cadenpage/rotom/legacy/pixi.md

[tasks]
ros2-build = "bash -lc 'cd /home/caden/Documents/rotom/src/ros2_ws; rm -rf build install log; source /opt/ros/humble/setup.bash; export COLCON_PYTHON_EXECUTABLE=/usr/bin/python3; colcon build --symlink-install --cmake-args -DPython3_EXECUTABLE=/usr/bin/python3; source install/setup.bash'"
ros2-control = "bash -lc 'export ROTOM_ROOT=/home/caden/Documents/rotom; export PYTHONPATH=/home/caden/Documents/rotom/src:/home/caden/Documents/rotom/.pixi/envs/default/lib/python3.10/site-packages:$PYTHONPATH; source /home/caden/Documents/rotom/src/ros2_ws/install/setup.bash; ros2 launch rotom_control rotom_control.launch.py'"
ros2-vision = "bash -lc 'export PIXI_LIB=/home/caden/Documents/rotom/.pixi/envs/default/lib; export PYTHONPATH=$PIXI_LIB/python3.10/site-packages:$PYTHONPATH; export LD_LIBRARY_PATH=$PIXI_LIB:$LD_LIBRARY_PATH; source /home/caden/Documents/rotom/src/ros2_ws/install/setup.bash; ros2 launch rotom_vision vision_pipeline.launch.py'"
ros2-vision-camera = "bash -lc 'export PIXI_LIB=/home/caden/Documents/rotom/.pixi/envs/default/lib; export PYTHONPATH=$PIXI_LIB/python3.10/site-packages:$PYTHONPATH; export LD_LIBRARY_PATH=$PIXI_LIB:$LD_LIBRARY_PATH; source /home/caden/Documents/rotom/src/ros2_ws/install/setup.bash; ros2 launch rotom_vision vision_pipeline.launch.py start_camera:=true'"
ros2-vision-servo = "bash -lc 'export ROTOM_ROOT=/home/caden/Documents/rotom; export PIXI_LIB=/home/caden/Documents/rotom/.pixi/envs/default/lib; export PYTHONPATH=/home/caden/Documents/rotom/src:$PIXI_LIB/python3.10/site-packages:$PYTHONPATH; export LD_LIBRARY_PATH=$PIXI_LIB:$LD_LIBRARY_PATH; source /home/caden/Documents/rotom/src/ros2_ws/install/setup.bash; ros2 launch rotom_vision vision_pipeline.launch.py start_camera:=true start_control:=true enable_servo:=true'"
ros2-marker-follow-dry = "bash -lc 'export ROTOM_ROOT=/home/caden/Documents/rotom; export PIXI_LIB=/home/caden/Documents/rotom/.pixi/envs/default/lib; export PYTHONPATH=/home/caden/Documents/rotom/src:$PIXI_LIB/python3.10/site-packages:$PYTHONPATH; export LD_LIBRARY_PATH=$PIXI_LIB:$LD_LIBRARY_PATH; source /home/caden/Documents/rotom/src/ros2_ws/install/setup.bash; ros2 launch rotom_vision marker_follow.launch.py'"
ros2-marker-follow-live = "bash -lc 'export ROTOM_ROOT=/home/caden/Documents/rotom; export PIXI_LIB=/home/caden/Documents/rotom/.pixi/envs/default/lib; export PYTHONPATH=/home/caden/Documents/rotom/src:$PIXI_LIB/python3.10/site-packages:$PYTHONPATH; export LD_LIBRARY_PATH=$PIXI_LIB:$LD_LIBRARY_PATH; source /home/caden/Documents/rotom/src/ros2_ws/install/setup.bash; ros2 launch rotom_vision marker_follow.launch.py enable_servo:=true'"
ros2-marker-follow-dry-rviz = "bash -lc 'export ROTOM_ROOT=/home/caden/Documents/rotom; export PIXI_LIB=/home/caden/Documents/rotom/.pixi/envs/default/lib; export PYTHONPATH=/home/caden/Documents/rotom/src:$PIXI_LIB/python3.10/site-packages:$PYTHONPATH; export LD_LIBRARY_PATH=$PIXI_LIB:$LD_LIBRARY_PATH; source /home/caden/Documents/rotom/src/ros2_ws/install/setup.bash; ros2 launch rotom_vision marker_follow.launch.py use_rviz:=true'"
ros2-marker-follow-live-rviz = "bash -lc 'export ROTOM_ROOT=/home/caden/Documents/rotom; export PIXI_LIB=/home/caden/Documents/rotom/.pixi/envs/default/lib; export PYTHONPATH=/home/caden/Documents/rotom/src:$PIXI_LIB/python3.10/site-packages:$PYTHONPATH; export LD_LIBRARY_PATH=$PIXI_LIB:$LD_LIBRARY_PATH; source /home/caden/Documents/rotom/src/ros2_ws/install/setup.bash; ros2 launch rotom_vision marker_follow.launch.py enable_servo:=true use_rviz:=true'"
ros2-marker-follow-moveit-dry = "bash -lc 'export ROTOM_ROOT=/home/caden/Documents/rotom; export PIXI_LIB=/home/caden/Documents/rotom/.pixi/envs/default/lib; export PYTHONPATH=/home/caden/Documents/rotom/src:$PIXI_LIB/python3.10/site-packages:$PYTHONPATH; export LD_LIBRARY_PATH=$PIXI_LIB:$LD_LIBRARY_PATH; source /home/caden/Documents/rotom/src/ros2_ws/install/setup.bash; ros2 launch rotom_moveit_config marker_follow_servo.launch.py'"
ros2-marker-follow-moveit-live = "bash -lc 'export ROTOM_ROOT=/home/caden/Documents/rotom; export PIXI_LIB=/home/caden/Documents/rotom/.pixi/envs/default/lib; export PYTHONPATH=/home/caden/Documents/rotom/src:$PIXI_LIB/python3.10/site-packages:$PYTHONPATH; export LD_LIBRARY_PATH=$PIXI_LIB:$LD_LIBRARY_PATH; source /home/caden/Documents/rotom/src/ros2_ws/install/setup.bash; ros2 launch rotom_moveit_config marker_follow_servo.launch.py enable_servo:=true'"
ros2-marker-follow-moveit-dry-rviz = "bash -lc 'export ROTOM_ROOT=/home/caden/Documents/rotom; export PIXI_LIB=/home/caden/Documents/rotom/.pixi/envs/default/lib; export PYTHONPATH=/home/caden/Documents/rotom/src:$PIXI_LIB/python3.10/site-packages:$PYTHONPATH; export LD_LIBRARY_PATH=$PIXI_LIB:$LD_LIBRARY_PATH; source /home/caden/Documents/rotom/src/ros2_ws/install/setup.bash; ros2 launch rotom_moveit_config marker_follow_servo.launch.py use_rviz:=true'"
ros2-marker-follow-moveit-live-rviz = "bash -lc 'export ROTOM_ROOT=/home/caden/Documents/rotom; export PIXI_LIB=/home/caden/Documents/rotom/.pixi/envs/default/lib; export PYTHONPATH=/home/caden/Documents/rotom/src:$PIXI_LIB/python3.10/site-packages:$PYTHONPATH; export LD_LIBRARY_PATH=$PIXI_LIB:$LD_LIBRARY_PATH; source /home/caden/Documents/rotom/src/ros2_ws/install/setup.bash; ros2 launch rotom_moveit_config marker_follow_servo.launch.py enable_servo:=true use_rviz:=true'"
ros2-drag-servo-dry = "bash -lc 'export ROTOM_ROOT=/home/caden/Documents/rotom; export PIXI_LIB=/home/caden/Documents/rotom/.pixi/envs/default/lib; export PYTHONPATH=/home/caden/Documents/rotom/src:$PIXI_LIB/python3.10/site-packages:$PYTHONPATH; export LD_LIBRARY_PATH=$PIXI_LIB:$LD_LIBRARY_PATH; source /home/caden/Documents/rotom/src/ros2_ws/install/setup.bash; ros2 launch rotom_vision drag_servo.launch.py'"
ros2-drag-servo-live = "bash -lc 'export ROTOM_ROOT=/home/caden/Documents/rotom; export PIXI_LIB=/home/caden/Documents/rotom/.pixi/envs/default/lib; export PYTHONPATH=/home/caden/Documents/rotom/src:$PIXI_LIB/python3.10/site-packages:$PYTHONPATH; export LD_LIBRARY_PATH=$PIXI_LIB:$LD_LIBRARY_PATH; source /home/caden/Documents/rotom/src/ros2_ws/install/setup.bash; ros2 launch rotom_vision drag_servo.launch.py enable_servo:=true'"
ros2-drag-servo-moveit-dry = "bash -lc 'export ROTOM_ROOT=/home/caden/Documents/rotom; export PIXI_LIB=/home/caden/Documents/rotom/.pixi/envs/default/lib; export PYTHONPATH=/home/caden/Documents/rotom/src:$PIXI_LIB/python3.10/site-packages:$PYTHONPATH; export LD_LIBRARY_PATH=$PIXI_LIB:$LD_LIBRARY_PATH; source /home/caden/Documents/rotom/src/ros2_ws/install/setup.bash; ros2 launch rotom_moveit_config drag_servo_moveit.launch.py'"
ros2-drag-servo-moveit-live = "bash -lc 'export ROTOM_ROOT=/home/caden/Documents/rotom; export PIXI_LIB=/home/caden/Documents/rotom/.pixi/envs/default/lib; export PYTHONPATH=/home/caden/Documents/rotom/src:$PIXI_LIB/python3.10/site-packages:$PYTHONPATH; export LD_LIBRARY_PATH=$PIXI_LIB:$LD_LIBRARY_PATH; source /home/caden/Documents/rotom/src/ros2_ws/install/setup.bash; ros2 launch rotom_moveit_config drag_servo_moveit.launch.py enable_servo:=true'"
calibrate-camera = "bash -lc 'export PIXI_LIB=/home/caden/Documents/rotom/.pixi/envs/default/lib; export PYTHONPATH=$PIXI_LIB/python3.10/site-packages:$PYTHONPATH; export LD_LIBRARY_PATH=$PIXI_LIB:$LD_LIBRARY_PATH; source /home/caden/Documents/rotom/src/ros2_ws/install/setup.bash; python /home/caden/Documents/rotom/src/examples/charuco_calibrate.py'"
charuco-camera = { cmd = "true", depends-on = ["ros2-vision-camera"] }
charuco-calibrate = { cmd = "true", depends-on = ["calibrate-camera"] }
move-group = "bash -lc 'source /home/caden/Documents/rotom/src/ros2_ws/install/setup.bash; ros2 launch rotom_moveit_config move_group.launch.py'"
moveit-rviz = "bash -lc 'source /home/caden/Documents/rotom/src/ros2_ws/install/setup.bash; ros2 launch rotom_moveit_config moveit_rviz.launch.py'"
moveit-demo-real = "bash -lc 'source /home/caden/Documents/rotom/src/ros2_ws/install/setup.bash; ros2 launch rotom_moveit_config demo.launch.py use_ros2_control:=false'"
calibration-gui = "bash -lc 'export PYTHONPATH=/home/caden/Documents/rotom/src:/home/caden/Documents/rotom/.pixi/envs/default/lib/python3.10/site-packages:$PYTHONPATH; python -m motors.calibration_gui'"
homing-offset = "bash -lc 'export PYTHONPATH=/home/caden/Documents/rotom/src:/home/caden/Documents/rotom/.pixi/envs/default/lib/python3.10/site-packages:$PYTHONPATH; python /home/caden/Documents/rotom/src/examples/homing_offset.py'"
home = "bash -lc 'export PYTHONPATH=/home/caden/Documents/rotom/src:/home/caden/Documents/rotom/.pixi/envs/default/lib/python3.10/site-packages:$PYTHONPATH; python /home/caden/Documents/rotom/src/examples/home.py'"
export-joint-limits = "bash -lc 'export PYTHONPATH=/home/caden/Documents/rotom/src:/home/caden/Documents/rotom/.pixi/envs/default/lib/python3.10/site-packages:$PYTHONPATH; python /home/caden/Documents/rotom/src/examples/export_joint_limits.py'"
