cadenpage/rotom/imgs/onshape.png

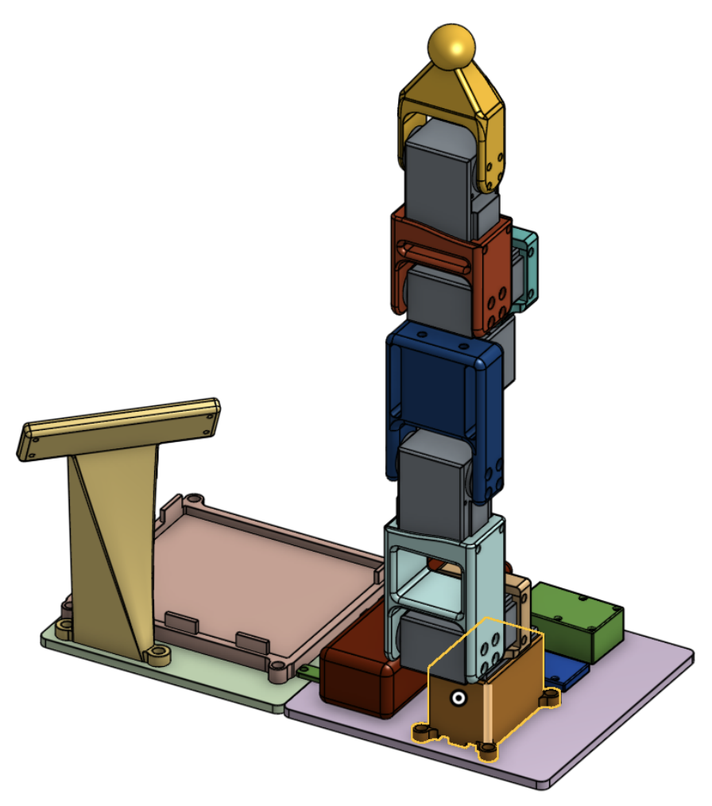
imgs/onshape.png
