cadenpage/rotom/src/ros2_ws/src/rotom_description/meshes/visual/link4.stl

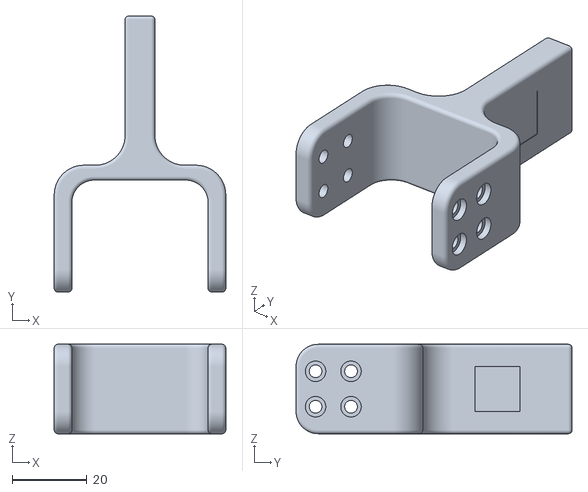
[picture p5: CAD file, 2026-03-18]
src/ros2_ws/src/rotom_description/meshes/visual/link4.stl
46.0 x 74.0 x 24.0
