cadenpage/rotom/src/ros2_ws/src/rotom_description/meshes/visual/ground.stl

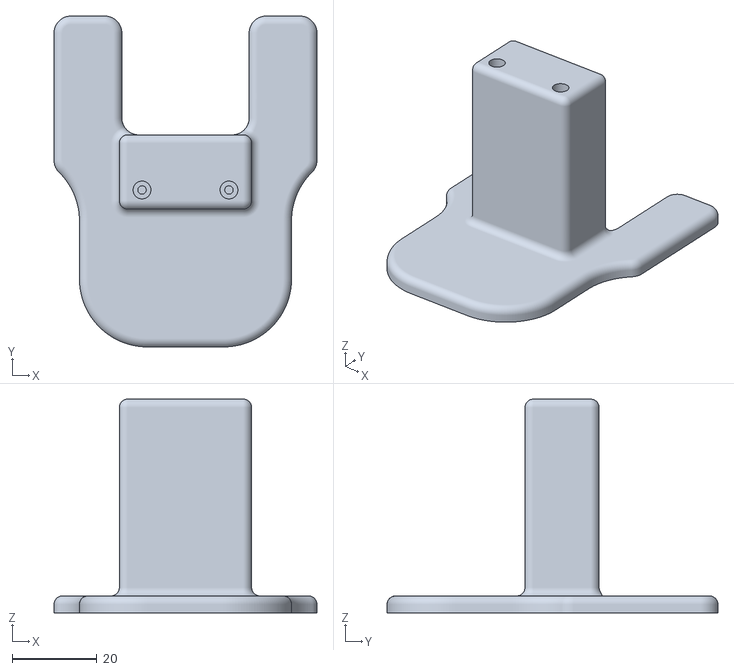
[picture p6: CAD file, 2026-03-17]
src/ros2_ws/src/rotom_description/meshes/visual/ground.stl
62.0 x 78.0 x 50.4
