cadenpage/rotom/src/ros2_ws/src/rotom_description/meshes/visual/flick2claw.stl

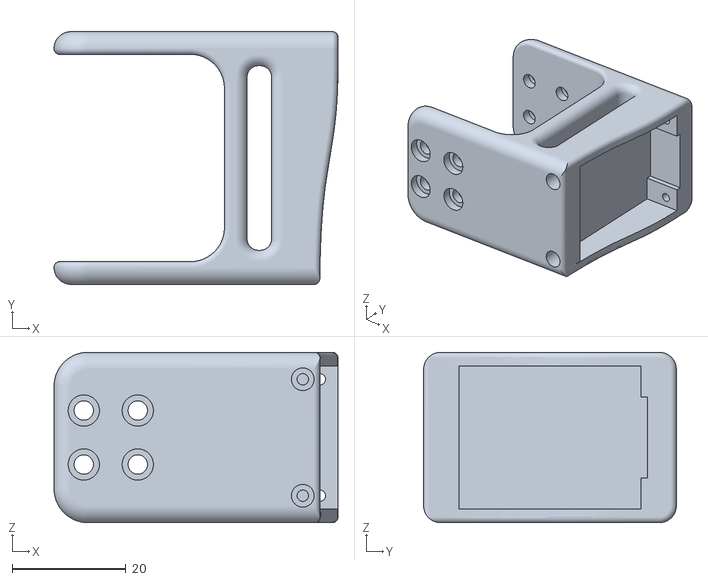
[picture p7: CAD file, 2026-01-10]
src/ros2_ws/src/rotom_description/meshes/visual/flick2claw.stl
50.0 x 44.5 x 30.0
