cadenpage/rotom/legacy/current_robot_2026-03/src/ros2_ws/src/rotom_description/meshes/visual/wrist2flick.stl

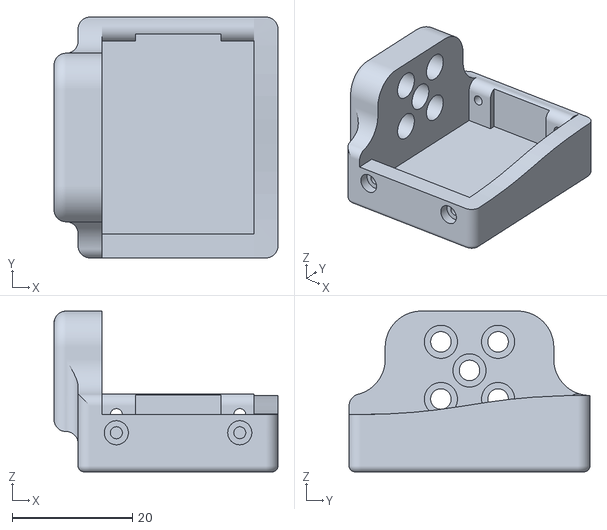
[picture p8: CAD file, 2026-01-09, an earlier design]
legacy/current_robot_2026-03/src/ros2_ws/src/rotom_description/meshes/visual/wrist2flick.stl
37.2 x 40.0 x 26.7
