cadenpage/rotom/legacy/current_robot_2026-03/src/ros2_ws/src/rotom_description/meshes/visual/EE.stl

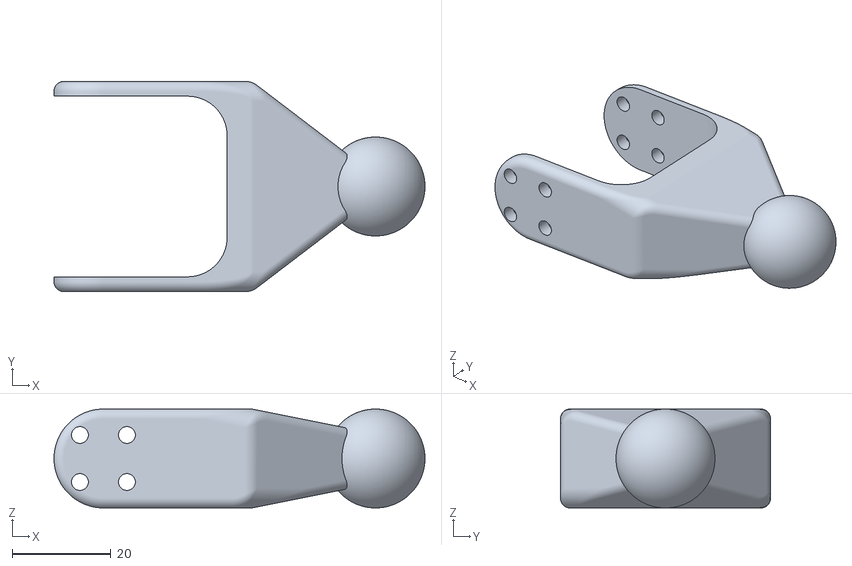
[picture p9: CAD file, 2026-01-09, an earlier design]
legacy/current_robot_2026-03/src/ros2_ws/src/rotom_description/meshes/visual/EE.stl
75.0 x 42.5 x 20.0
