cadenpage/rotom/legacy/current_robot_2026-03/src/ros2_ws/src/rotom_description/meshes/visual/shoulder2elbow.stl

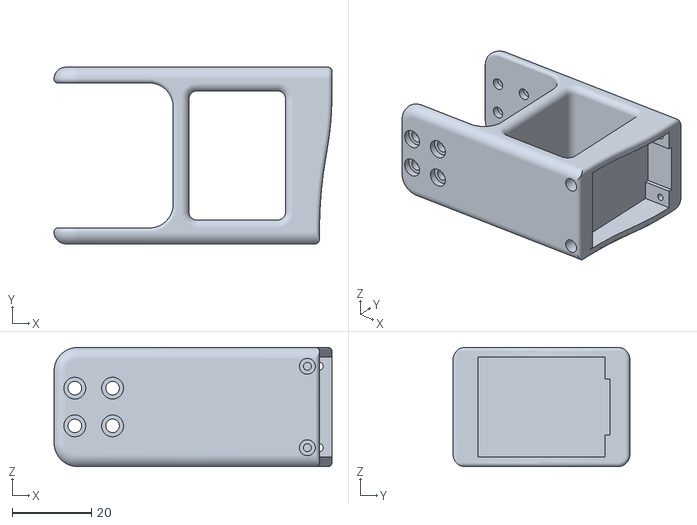
[picture p10: CAD file, 2026-01-09, an earlier design]
legacy/current_robot_2026-03/src/ros2_ws/src/rotom_description/meshes/visual/shoulder2elbow.stl
70.0 x 44.5 x 30.0
