cadenpage/rotom/legacy/current_robot_2026-03/src/ros2_ws/src/rotom_description/meshes/visual/origin2base.stl

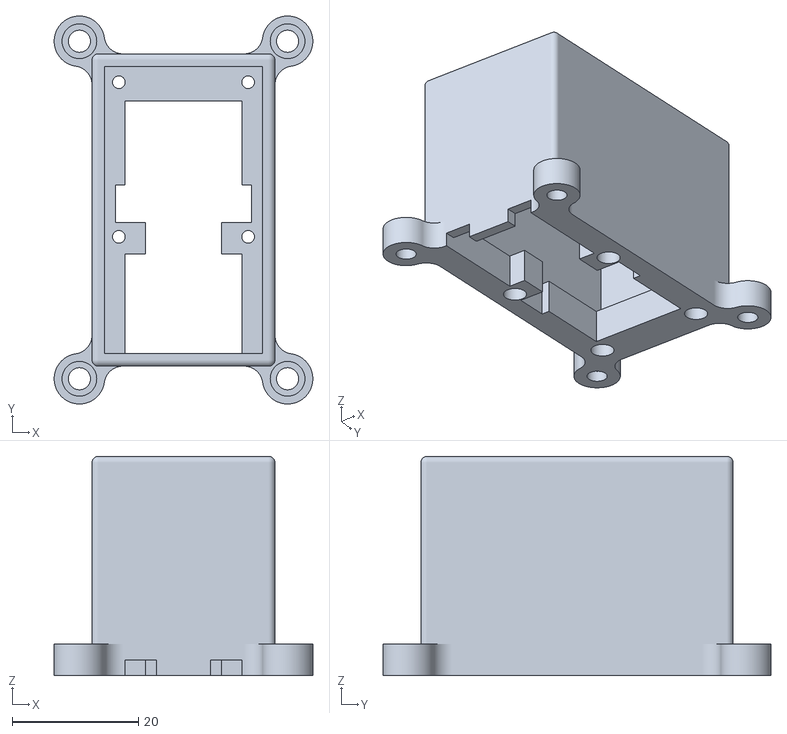
[picture p11: CAD file, 2026-01-09, an earlier design]
legacy/current_robot_2026-03/src/ros2_ws/src/rotom_description/meshes/visual/origin2base.stl
41.0 x 61.5 x 34.8
