cadenpage/rotom/legacy/current_robot_2026-03/src/ros2_ws/src/rotom_description/meshes/visual/base2shoulder.stl

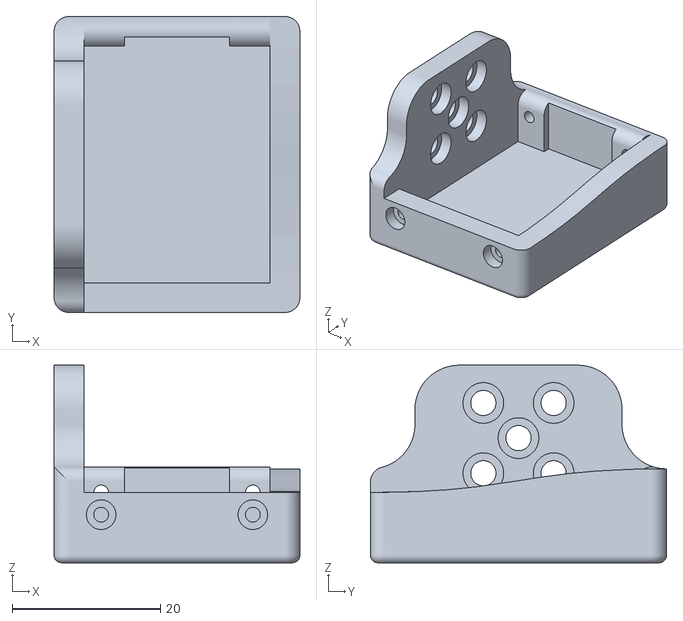
[picture p12: CAD file, 2026-01-09, an earlier design]
legacy/current_robot_2026-03/src/ros2_ws/src/rotom_description/meshes/visual/base2shoulder.stl
33.2 x 40.0 x 26.7
