cadenpage/rotom/src/ros2_ws/src/rotom_description/urdf/rotom.urdf.xacro

<?xml version="1.0"?>
<robot name="rotom" xmlns:xacro="http://www.ros.org/wiki/xacro">

  <xacro:property name="mesh_scale" value="0.001"/>

    <material name="gray">
        <color rgba="0.5 0.5 0.5 1.0"/>
    </material>
    <material name="yellow">
        <color rgba="1.0 1.0 0.0 1.0"/>
    </material>
    <material name="red">
        <color rgba="1.0 0.0 0.0 1.0"/>
    </material>
    <material name="green">
        <color rgba="0.0 1.0 0.0 1.0"/>
    </material>
    <material name="blue">
        <color rgba="0.0 0.0 1.0 1.0"/>
    </material>





    <link name="world"/>

    <link name="ground">
    <visual>
      <origin xyz="0 0 0" rpy="0 0 0"/>
      <material name="gray"/>
      <geometry>
        <mesh filename="package://rotom_description/meshes/visual/ground.stl" scale="${mesh_scale} ${mesh_scale} ${mesh_scale}"/>
      </geometry>
    </visual>
    <collision>
      <origin xyz="0 0 0" rpy="0 0 0"/>
      <geometry>
        <mesh filename="package://rotom_description/meshes/visual/ground.stl" scale="${mesh_scale} ${mesh_scale} ${mesh_scale}"/>
      </geometry>
    </collision>
  </link>

  <link name="link1">
    <visual>
      <origin xyz="0.05 0.012 -0.023" rpy="0 0 0"/>
      <material name="red"/>
      <geometry>
        <mesh filename="package://rotom_description/meshes/visual/link1.stl" scale="${mesh_scale} ${mesh_scale} ${mesh_scale}"/>
      </geometry>
    </visual>
    <collision>
      <origin xyz="0.05 0.012 -0.023" rpy="0 0 0"/>
      <geometry>
        <mesh filename="package://rotom_description/meshes/visual/link1.stl" scale="${mesh_scale} ${mesh_scale} ${mesh_scale}"/>
      </geometry>
    </collision>
  </link>

  <link name="link2">
    <visual>
      <origin xyz="0.0 0.02 -0.012" rpy="0 0 0"/>
      <material name="green"/>
      <geometry>
        <mesh filename="package://rotom_description/meshes/visual/link2.stl" scale="${mesh_scale} ${mesh_scale} ${mesh_scale}"/>
      </geometry>
    </visual>
    <collision>
      <origin xyz="0.0 0.02 -0.012" rpy="0 0 0"/>
      <geometry>
        <mesh filename="package://rotom_description/meshes/visual/link2.stl" scale="${mesh_scale} ${mesh_scale} ${mesh_scale}"/>
      </geometry>
    </collision>
  </link>



    <link name="link3">
    <visual>
      <origin xyz="0.0 0.02 -0.012" rpy="0 0 0"/>
      <material name="blue"/>
      <geometry>
        <mesh filename="package://rotom_description/meshes/visual/link3.stl" scale="${mesh_scale} ${mesh_scale} ${mesh_scale}"/>
      </geometry>
    </visual>
    <collision>
      <origin xyz="0.0 0.02 -0.012" rpy="0 0 0"/>
      <geometry>
        <mesh filename="package://rotom_description/meshes/visual/link3.stl" scale="${mesh_scale} ${mesh_scale} ${mesh_scale}"/>
      </geometry>
    </collision>
  </link>


  <link name="link4">
    <visual>
      <origin xyz="0.0 0.02 -0.012" rpy="0 0 0"/>
      <material name="yellow"/>
      <geometry>
        <mesh filename="package://rotom_description/meshes/visual/link4.stl" scale="${mesh_scale} ${mesh_scale} ${mesh_scale}"/>
      </geometry>
    </visual>
    <collision>
      <origin xyz="0.0 0.02 -0.012" rpy="0 0 0"/>
      <geometry>
        <mesh filename="package://rotom_description/meshes/visual/link4.stl" scale="${mesh_scale} ${mesh_scale} ${mesh_scale}"/>
      </geometry>
    </collision>
  </link>

  <link name="tool0">
    <visual>
      <origin xyz="0 0 0" rpy="0 0 0"/>
      <geometry>
        <box size="0.01 0.01 0.01"/>
      </geometry>
      <material name="gray"/>
    </visual>
    <collision>
      <origin xyz="0 0 0" rpy="0 0 0"/>
      <geometry>
        <box size="0.01 0.01 0.01"/>
      </geometry>
    </collision>
  </link>







  <joint name="ground" type="fixed">
    <parent link="world"/>
    <child link="ground"/>
  </joint>

  <joint name="O" type="revolute">
    <parent link="ground"/>
    <child link="link1"/>
    <origin xyz="0 0.02 0.0292" rpy="0 0 1.570796"/>
    <axis xyz="0 0 1"/>
    <limit lower="-1.787524" upper="1.787524" effort="5.0" velocity="3.0"/>
  </joint>

  <joint name="A" type="revolute">
    <parent link="link1"/>
    <child link="link2"/>
    <origin xyz="0.0344 0 0.0615" rpy="0 0 1.570796"/>
    <axis xyz="-1 0 0"/>
    <limit lower="-3.141593" upper="0.405070" effort="5.0" velocity="3.0"/>
  </joint>

  <joint name="B" type="revolute">
    <parent link="link2"/>
    <child link="link3"/>
    <origin xyz="0 0.0996 0.029" rpy="3.141593 0 0"/>
    <axis xyz="-1 0 0"/>
    <limit lower="-0.0421948" upper="3.141593" effort="5.0" velocity="3.0"/>
  </joint>

  <joint name="C" type="revolute">
    <parent link="link3"/>
    <child link="link4"/>
    <origin xyz="0 0.1215 0.0" rpy="-1.570796 0 0"/>
    <axis xyz="-1 0 0"/>
    <limit lower="-3.141593" upper="0.377451" effort="5.0" velocity="3.0"/>
  </joint>

  <joint name="tool0_fixed" type="fixed">
    <parent link="link4"/>
    <child link="tool0"/>
    <origin xyz="0 0.064 0.0" rpy="-1.570796 0 -1.570796"/>
  </joint>






</robot>
