cadenpage/rotom/src/ros2_ws/src/rotom_control/config/rotom_control.yaml

rotom_motor_bridge:
  ros__parameters:
    port: "/dev/ttyACM0"
    protocol_version: 0
    handshake: false
    enable_torque: true
    configure_motors_on_start: true
    maximum_acceleration: 60
    acceleration: 45
    publish_rate_hz: 30.0
    command_topic: "/joint_command"
    state_topic: "/joint_states"
    trajectory_action: "/arm_controller/follow_joint_trajectory"
    enable_trajectory_action: true
    trajectory_command_topic: "/servo_node/joint_trajectory"
    enable_trajectory_topic: true
    trajectory_goal_tolerance: 0.15
    trajectory_goal_timeout_sec: 8.0
    sync_read_retries: 2
    sync_write_retries: 1
    joint_names:
      - base_to_shoulder
      - shoulder_to_elbow
      - elbow_to_wrist
      - wrist_to_flick
      - flick_to_claw
      - flick_to_ee
    motor_names:
      - Base
      - Shoulder
      - Elbow
      - Wrist
      - Flick
      - EE
    motor_ids: [6, 5, 4, 3, 2, 1]
    motor_models:
      - sts3215
      - sts3215
      - sts3215
      - sts3215
      - sts3215
      - sts3215
    lower_limits:
      - -3.141593
      - -0.322215
      - -2.192594
      - -3.141593
      - -1.480653
      - -2.023815
    upper_limits:
      - 3.141593
      - 0.446497
      - 1.410073
      - 3.141593
      - 0.348299
      - 2.178785
    joint_signs:
      - -1
      - -1
      - -1
      - -1
      - -1
      - 1
