cadenpage/rotom/src/ros2_ws/src/rotom_moveit_config/launch/setup_assistant.launch.py

from moveit_configs_utils import MoveItConfigsBuilder
from moveit_configs_utils.launches import generate_setup_assistant_launch


def generate_launch_description():
    moveit_config = MoveItConfigsBuilder("rotom", package_name="rotom_moveit_config").to_moveit_configs()
    return generate_setup_assistant_launch(moveit_config)
