cadenpage/rotom/src/ros2_ws/src/rotom_moveit_config/launch/static_virtual_joint_tfs.launch.py

from moveit_configs_utils import MoveItConfigsBuilder
from moveit_configs_utils.launches import generate_static_virtual_joint_tfs_launch


def generate_launch_description():
    moveit_config = MoveItConfigsBuilder("rotom", package_name="rotom_moveit_config").to_moveit_configs()
    return generate_static_virtual_joint_tfs_launch(moveit_config)
