cadenpage/rotom/(commit log)

2025-12-18 Add guide for setting up Jetson Orin Nano headless GUI with macOS Screen Sharing
2025-12-18 migrate low level motor control python files
2025-12-18 Restructured files in motors and modified initialization file to allow imports whule not on same path
2025-12-18 proper licensing to give credit of low level motor control to hugging face
2025-12-22 Added some useful examples for callibration, homing offsets, homing, ID writing and changing the torque modes
2026-01-09 imported and. viewing stl in rviz
    [EE.stl, base2shoulder.stl, elbow2wrist.stl, origin2base.stl, rotom.urdf, rotom.urdf.xacro, shoulder2elbow.stl, wrist2flick.stl]
2026-01-09 Several hours later working config files and usage instructions for ros with mac and jetson
    [rotom.urdf.xacro]
2026-01-10 Most of robot put together
    [flick2claw.stl, rotom.urdf.xacro]
2026-01-10 completed robot... for now
    [rotom.urdf.xacro]
2026-02-22 uptate builds
    [EE.stl, base2shoulder.stl, elbow2wrist.stl, flick2claw.stl, joint_limits.yaml, origin2base.stl, ros2_controllers.yaml, rotom.ros2_control.xacro]
2026-02-22 end effector homing
2026-02-22 control note + moveit tuning
    [rotom.urdf.xacro]
2026-02-23 control works!!
    [rotom.urdf.xacro]
2026-02-24 new demos
    [EE 2.stl, base2shoulder 2.stl, elbow2wrist 2.stl, origin2base 2.stl, rotom.urdf 2.xacro, shoulder2elbow 2.stl, wrist2flick 2.stl]
2026-02-24 motor bridge
2026-02-27 export joint limits file fixed, ik solver converges, my life is complete
    [EE.stl, base2shoulder.stl, elbow2wrist.stl, flick2claw.stl, joint_limits.yaml, origin2base.stl, rotom.urdf.xacro, shoulder2elbow.stl]
2026-03-05 calibration ready
    [EE.stl, base2shoulder.stl, elbow2wrist.stl, flick2claw.stl, origin2base.stl, rotom.urdf.xacro, shoulder2elbow.stl, wrist2flick.stl]
2026-03-16 calib to yaml implemented. ready for vision
    [camera_calibration.yaml]
2026-03-17 new robot build and setup creation
    [ground.stl, rotom.urdf.xacro]
2026-03-17 first motor in. now setting up servo control. hopefully moveit works
    [rotom.urdf.xacro]
2026-03-17 moveit set up with new robot
    [joint_limits.yaml, ros2_controllers.yaml, rotom.ros2_control.xacro, rotom.urdf.xacro]
2026-03-18 aruco following works
    [camera_calibration.yaml, joint_limits.yaml, link4.stl, moveit_servo.yaml, ros2_controllers.yaml, rotom.ros2_control.xacro, rotom.urdf.xacro]
2026-03-18 switched out pixi for system compatible venv and just recipes
2026-03-19 frame updates
2026-03-19 new task space
    [moveit_servo.yaml, planar_task_controller.yaml]
2026-03-19 smoothness update
    [planar_task_controller.yaml]
2026-03-19 teleop done
    [planar_task_controller.yaml]
